GeorgiaTechSystemResearch/GT_MUR_Open_Source_Package/README.md

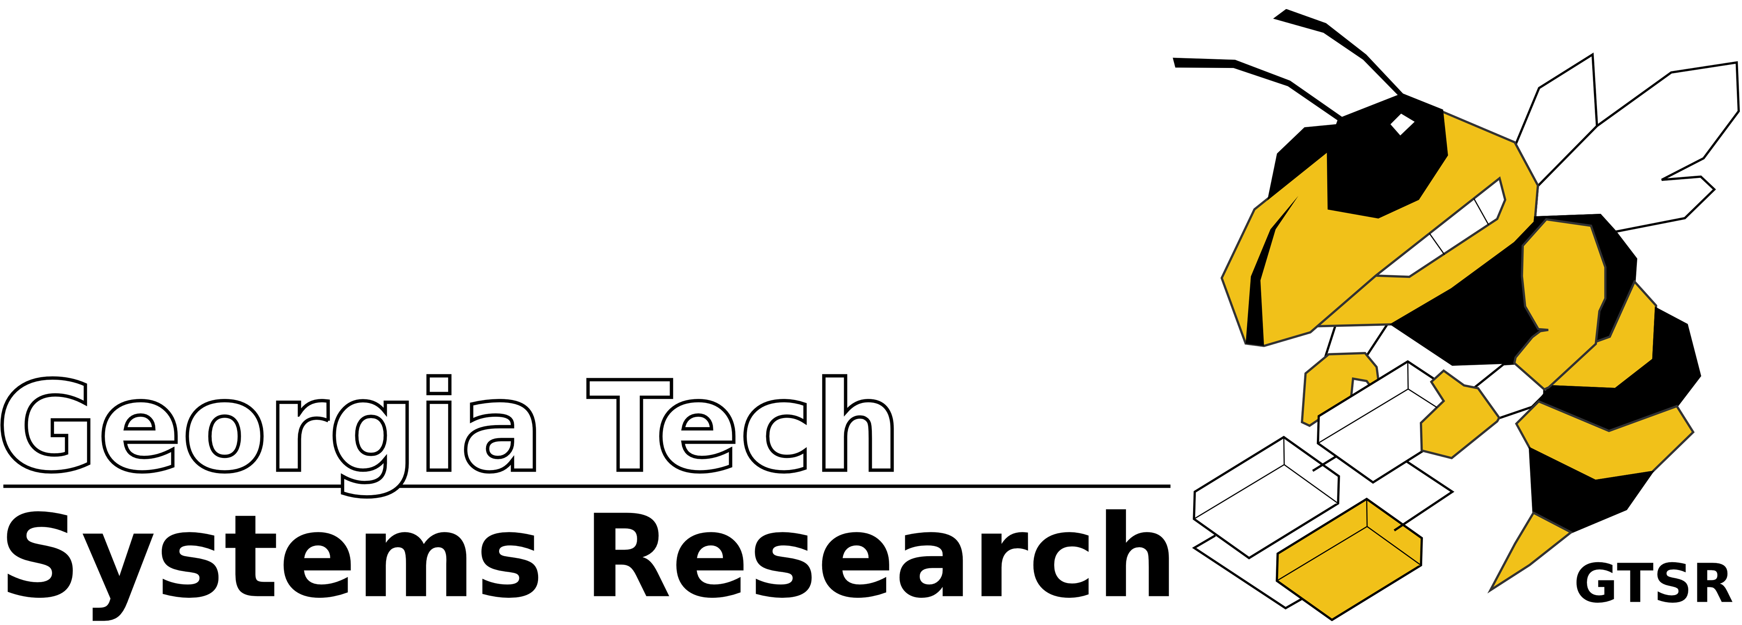
[picture p1: GTSR_logo.png]
