GeorgiaTechSystemResearch/GT_MUR_Open_Source_Package/Mechanical_Design_Files/Dimension_of_Devices/arduino.jpg

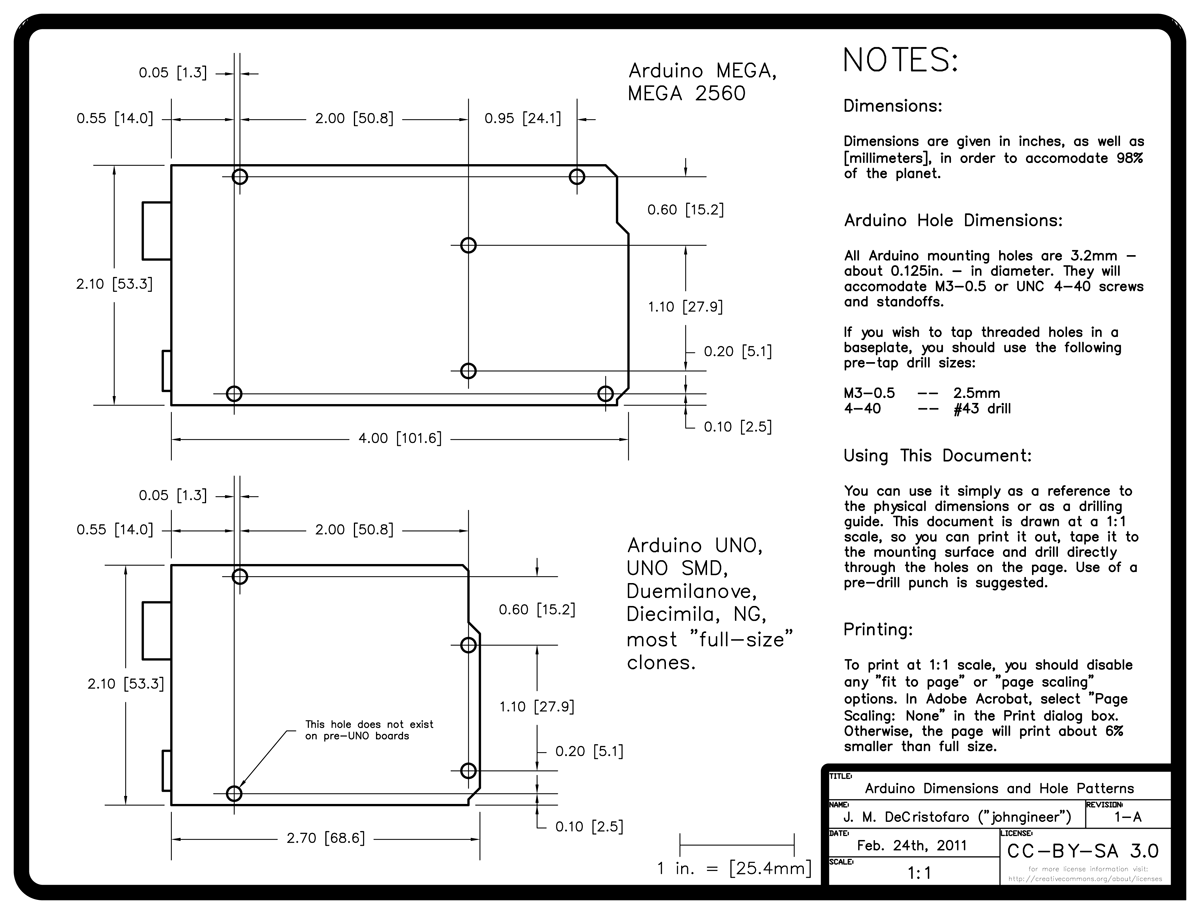
Mechanical_Design_Files/Dimension_of_Devices/arduino.jpg
