GeorgiaTechSystemResearch/GT_MUR_Open_Source_Package/Mechanical_Design_Files/Dimension_of_Devices/ir module V2.png

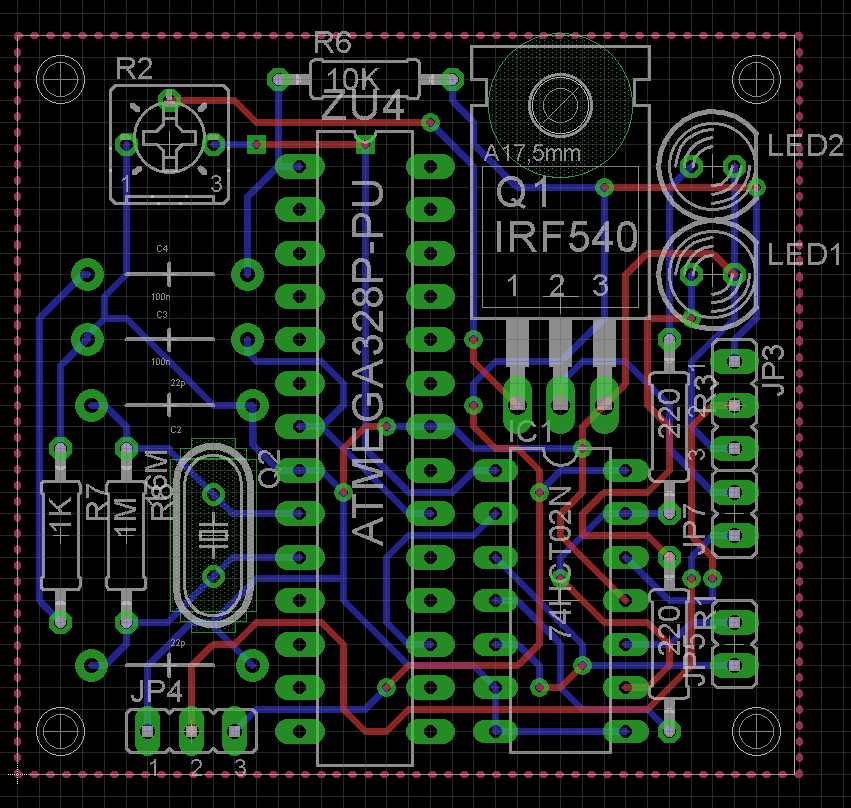
Mechanical_Design_Files/Dimension_of_Devices/ir module V2.png
