GeorgiaTechSystemResearch/GT_MUR_Open_Source_Package/Mechanical_Design_Files/Dimension_of_Devices/LCD_button.JPG

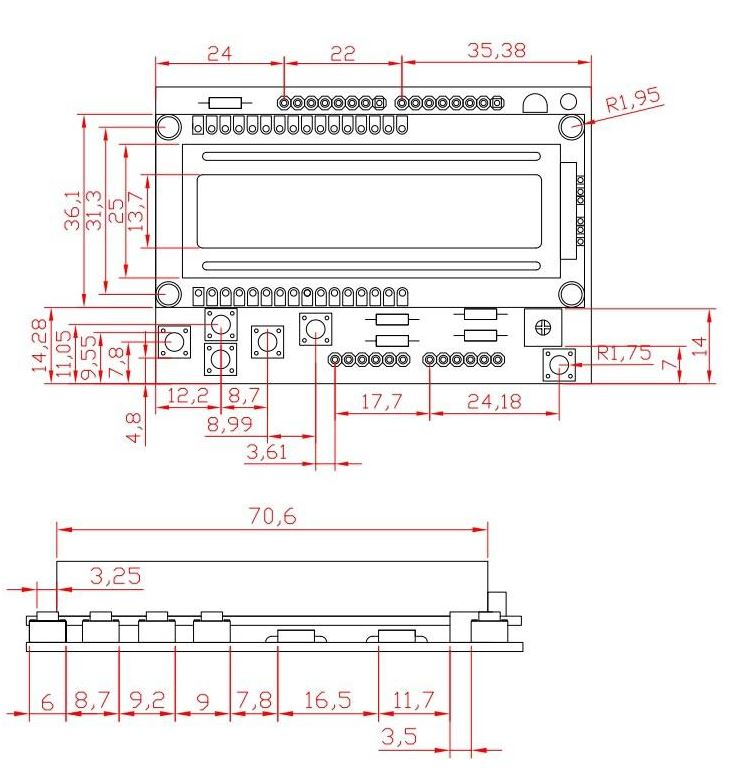
Mechanical_Design_Files/Dimension_of_Devices/LCD_button.JPG
