GeorgiaTechSystemResearch/GT_MUR_Open_Source_Package/Documents/Part_List.xlsx

Mechanical Structure
Part Name | Distributor / Manufacturer | Model / Description / Link
Acrylic Sheet (thin) | Home Depot or Amazon | ~0.125 inch thichness
Acrilic Sheet | Home Depot or Amazon | 0.22/0.25 inch thickness
Acrilic Tube | Amazon | 3 inch OD, 0.22/0.25 inch wall thickness
Rubber Sheet | Amazon or McMaster | 0.125 inch thickness
threaded rod | Home Depot or McMaster | 10-24 thread
wing nuts | Home Depot or McMaster | 10-24 thread
hex nuts | Home Depot or McMaster | 10-24 thread
Nylon screws & nuts | McMaster | M2.5, Nylon
Spacers | McMaster | M2.5 * 5mm and M2.5 * 10mm, Nylon
Electronics - handhold controller
Part Name | Distributor | Model / Description / Link
Arduino Mega 2560 R3 | Amazon / Arduino | Arduino Board with Atmega 2560
Adapter PCB | DFRobot | Design files available in the package
Thumb Joystick | Sparkfun | https://www.sparkfun.com/products/9032
Breakout Board for Thumb Joystick | Sparkfun | https://www.sparkfun.com/products/9110
slide potentiometer | Mouser / Bourns | 10Kohms, 60mm Travel, Center Detent, PTL60-10G1-103B2
Lithium battery | Amazon / Venom | 11.1V, 2200mah, 20C
LCD screen with pushbuttons | Sparkfun | https://www.sparkfun.com/products/11851
DC-DC converter | Amazon / Hobbywing | Hobbywing 5V/6V 3A Switch-mode UBEC
IR transmitter Module | GTSR made | Design files available in the package
Infrered receiver module | Mouser / Vishay | Infrared Receivers 2.5-5.5V 38kHz, TSOP38238
Infrered LED | Mouser / LED Engin | High Power, 940nm Dual Junction, LZ1-10R702
Heatsink | Major Distributors | Altuminum heatsink
Electronics - underwater vehicle
Arduino Mega 2560 R3 | Amazon / Arduino | Arduino Board with Atmega 2560
motors | Turnigy | Aerodrive DST-700 Brushless Outrunner motor 700kv
propeller | Graupner | Graupner 2308.60 and 2308.60L
DC-DC converter | Amazon / Hobbywing | Hobbywing 5V/6V 3A Switch-mode UBEC
motor driver holder PCB | DFRobot | Design files available in the package
10-DOF IMU | Adafruit | Adafruit 10-DOF IMU Breakout
Pressure sensor | Measurement Specialties | MS5803-14BA
IR transmitter Module | GTSR made | Design files available in the package
Infrered LED | Mouser / LED Engin | High Power, 940nm Dual Junction, LZ1-10R702
Infrered receiver module | Mouser / Vishay | Infrared Receivers 2.5-5.5V 38kHz, TSOP38238
Heatsink | Major Distributors | Altuminum heatsink
Electronics - IR Transmitter Module
PCB | DFRobot | Design files available in the package
Potentiometer | Mouser / Bourns | 10KOHMS, Through Hole 1/4"SQ, 3362P-1-103LF
Logic Gate | Mouser / Texas Instruments | NOR gate, SN74HC02N
Atmega328P | Mouser / Atmel | 8-bit Microcontroller, ATMEGA328P-PU
MOSFET | Mouser / Fairchild | 60V N-Channel QFET Logic Level, FQP30N06L
Crystal, 16MHz | Sparkfun | https://www.sparkfun.com/products/536
Capacitor, 22pf | Sparkfun | https://www.sparkfun.com/products/8571
Capacitor, 0.1uf | Mouser / TDK | Multilayer Ceramic Capacitor, 0.1uF, X7R
Led | Major Distributors | 5mm LED, Yellow and Green
Resistor*4 | Major Distributors | General Purpose 1/4W through hole resistors
Pin header | Major Distributors | Pin header, 0.1 inch pitch
