GeorgiaTechSystemResearch/GT_MUR_Open_Source_Package/Mechanical_Design_Files/Hand_hold_Controller/hand_hold_controller.dxf

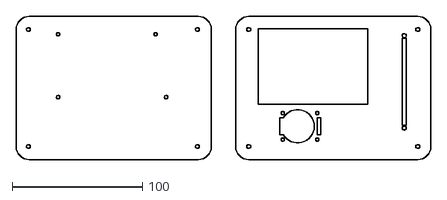
[picture p7: CAD file, 2016-12-27]
Mechanical_Design_Files/Hand_hold_Controller/hand_hold_controller.dxf
318.8 x 110.0
