GeorgiaTechSystemResearch/GT_MUR_Open_Source_Package/Mechanical_Design_Files/Underwater_Vehicle/middle plate.dxf

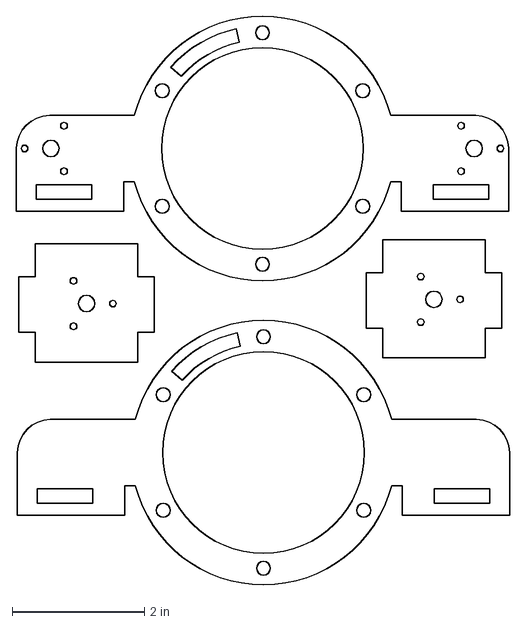
[picture p8: CAD file, 2016-12-27]
Mechanical_Design_Files/Underwater_Vehicle/middle plate.dxf
7.45 x 8.60 in
