GeorgiaTechSystemResearch/GT_MUR_Open_Source_Package/Mechanical_Design_Files/Underwater_Vehicle/middle plate2.dxf

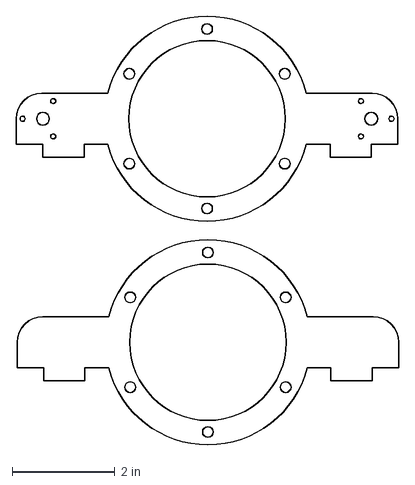
[picture p9: CAD file, 2016-12-27]
Mechanical_Design_Files/Underwater_Vehicle/middle plate2.dxf
7.46 x 8.36 in
