GeorgiaTechSystemResearch/GT_MUR_Open_Source_Package/Mechanical_Design_Files/Underwater_Vehicle/vehicle_stand.dxf

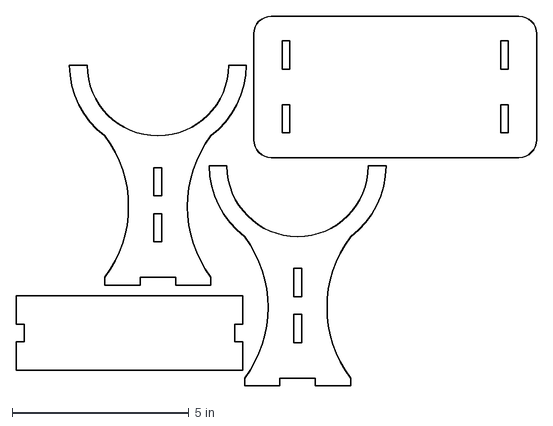
[picture p10: CAD file, 2016-12-27]
Mechanical_Design_Files/Underwater_Vehicle/vehicle_stand.dxf
14.7 x 10.5 in
