GeorgiaTechSystemResearch/GT_MUR_Open_Source_Package/Mechanical_Design_Files/Underwater_Vehicle/electronic_chassis.dxf

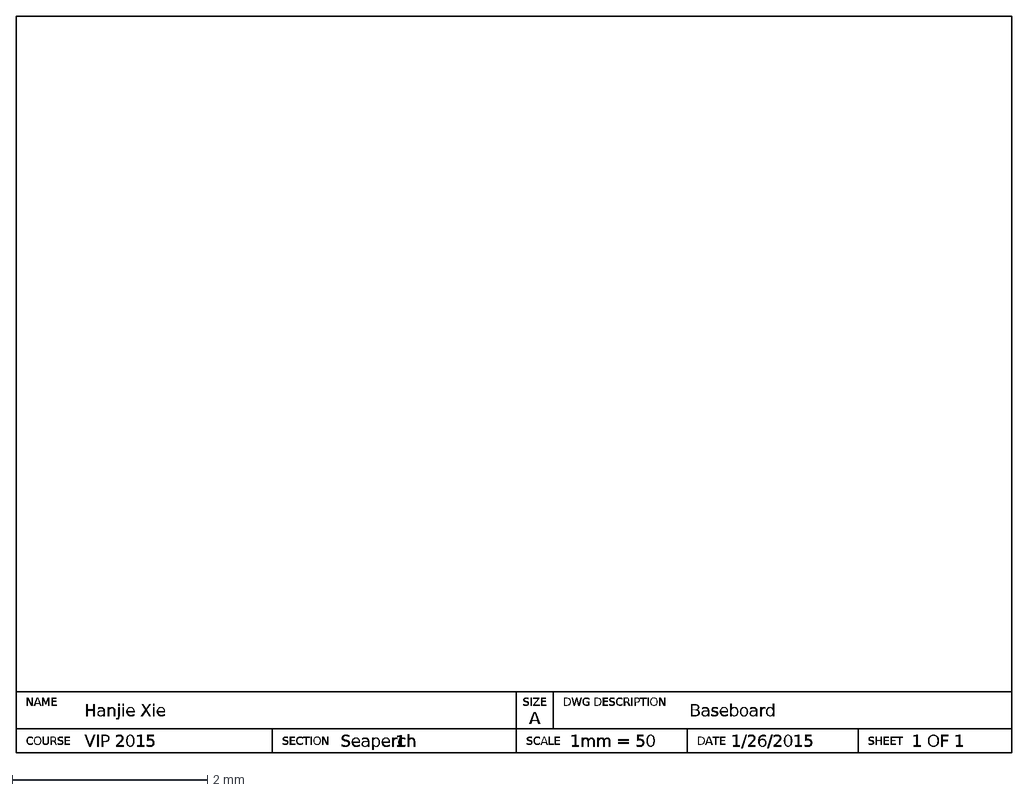
[picture p11: CAD file, 2016-12-27]
Mechanical_Design_Files/Underwater_Vehicle/electronic_chassis.dxf
SIZE
DWG DESCRIPTION
SCALE
NAME
COURSE
SECTION
DATE
SHEET
VIP 2015
A
Hanjie Xie
Seaperch
1mm = 50
1/26/2015
1 OF 1
Baseboard
1
