GeorgiaTechSystemResearch/GT_MUR_Open_Source_Package/(list of files, cad)

Other CAD files:
Mechanical_Design_Files/Underwater_Vehicle/rubber_pad.dwg
Mechanical_Design_Files/Underwater_Vehicle/end_cap with wire cut.dwg
Mechanical_Design_Files/Underwater_Vehicle/end_cap.dwg
