GeorgiaTechSystemResearch/GT_MUR_Open_Source_Package/Electronic_Design_Files/IR Module V3/IR_module_V3.brd

## EAGLE design Electronic_Design_Files/IR Module V3/IR_module_V3.brd (2016-12-27)

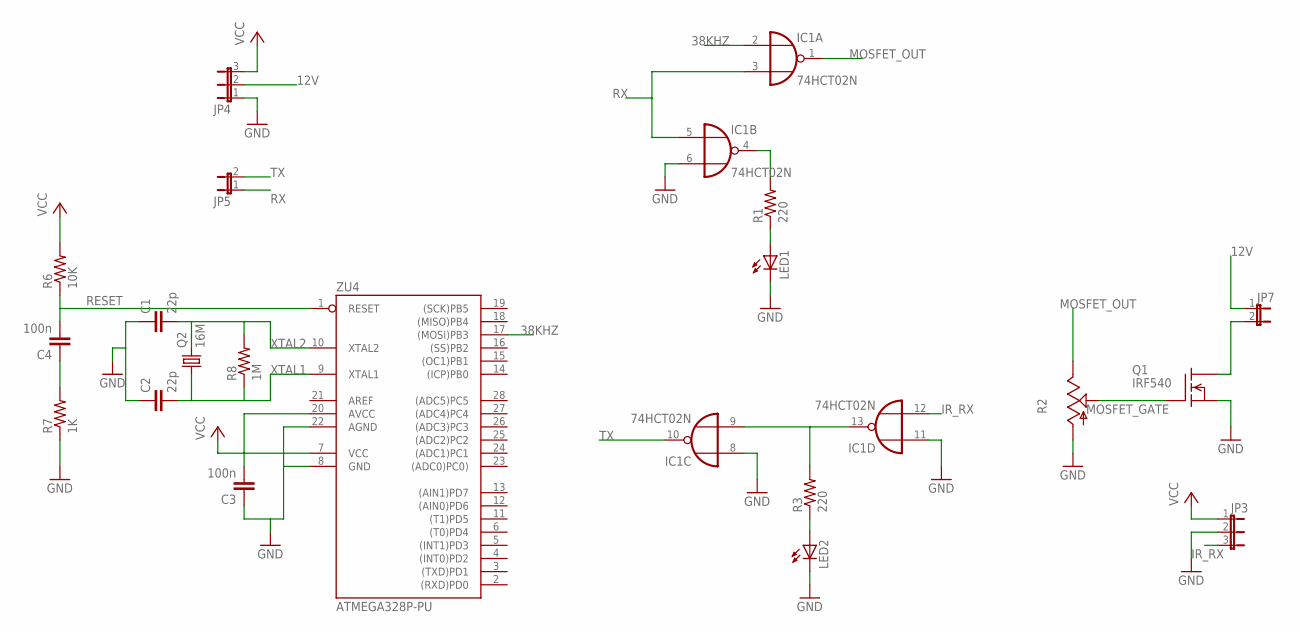
[picture p39: schematic IR_module_V3.sch]

Parts:
C1, C2: 22p; CAP-PTH-SMALLEZ
C3, C4: 100n; CAP-PTH-SMALLEZ
IC1: 74HCT02N; DIL14
JP3, JP4: JP2E; JP2
JP5, JP7: JP1E; JP1
LED1, LED2: LED5MM
Q1: IRF540; TO220
Q2: 16M; HC49/S
R1, R3: 220; 0207/10
R2: TRIM_US-B25P; B25P
R6: 10K; 0207/10
R7: 1K; 0207/10
R8: 1M; 0207/10
ZU4: ATMEGA328P-PU; DIL28-3

Connections:
12V: JP4.2, JP7.1
38KHZ: IC1.2 (I0), ZU4.17 ((MOSI)PB3)
GND: C1.1, C2.1, C3.1, IC1.6 (I1), IC1.7 (GND), IC1.8 (I0), IC1.11 (I0), JP3.2, JP4.1, LED1.K (C), LED2.K (C), Q1.3 (S), R2.A, R7.1, ZU4.8 (GND), ZU4.22 (AGND)
IR_RX: IC1.12 (I1), JP3.3
MOSFET_GATE: Q1.1 (G), R2.S
MOSFET_OUT: IC1.1 (O), R2.E
unnamed: IC1.4 (O), R1.2
unnamed: LED1.A, R1.1
unnamed: IC1.9 (I1), IC1.13 (O), R3.2
unnamed: LED2.A, R3.1
unnamed: JP7.2, Q1.2 (D)
unnamed: C4.1, R7.2
RESET: C4.2, R6.1, ZU4.1 (RESET)
RX: IC1.3 (I1), IC1.5 (I0), JP5.1
TX: IC1.10 (O), JP5.2
VCC: C3.2, IC1.14 (VCC), JP3.1, JP4.3, R6.2, ZU4.7 (VCC), ZU4.20 (AVCC)
XTAL1: C2.2, Q2.1, R8.1, ZU4.9 (XTAL1)
XTAL2: C1.2, Q2.2, R8.2, ZU4.10 (XTAL2)

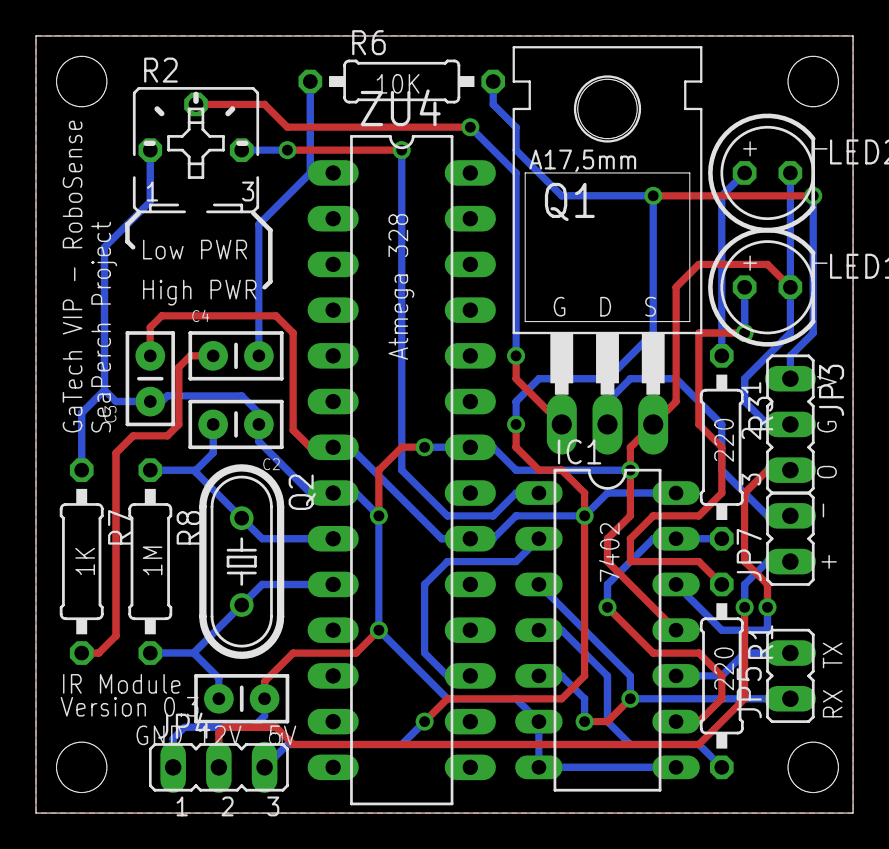
[picture p40: board IR_module_V3.brd from above]

Board: 2 copper layers, 45.4 x 43.2 mm, 20 parts (0 on the bottom side), 18 nets.
