GeorgiaTechSystemResearch/GT_MUR_Open_Source_Package/Electronic_Design_Files/Hand_Hold_Controller/Adapter Board/adapter.brd

## EAGLE design Electronic_Design_Files/Hand_Hold_Controller/Adapter Board/adapter.brd (2016-12-27)

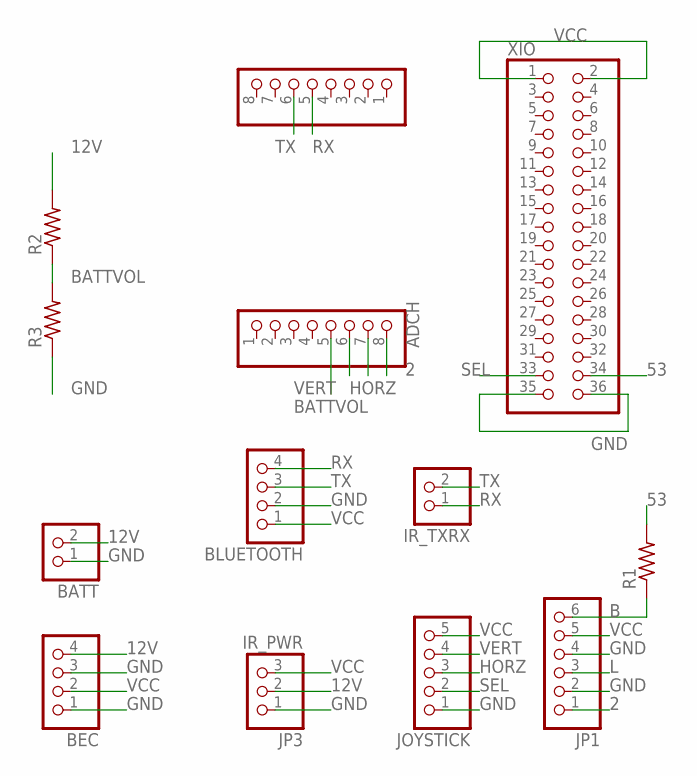
[picture p41: schematic adapter.sch]

Parts:
ADCH: 8x1F-H8.5; 1X08
BATT: PINHD-1X2/90; 1X02/90
BEC: PINHD-1X4/90; 1X04/90
BLUETOOTH: PINHD-1X4/90; 1X04/90
COMMUNICATION: 8x1F-H8.5; 1X08
IR_TXRX: PINHD-1X2/90; 1X02/90
JOYSTICK: PINHD-1X5/90; 1X05/90
JP1: PINHD-1X6/90; 1X06/90
JP3: IR_PWR; 1X03/90
R1, R2, R3: R-US_0207/10; 0207/10
XIO: PINHD-2X18; 2X18

Connections:
2: ADCH.8, JP1.1
12V: BATT.2, BEC.4, JP3.2, R2.2
53: R1.2, XIO.34
B: JP1.6, R1.1
BATTVOL: ADCH.5, R2.1, R3.2
GND: BATT.1, BEC.1, BEC.3, BLUETOOTH.2, JOYSTICK.1, JP1.2, JP1.4, JP3.1, R3.1, XIO.35, XIO.36
HORZ: ADCH.7, JOYSTICK.3
L: JP1.3
RX: BLUETOOTH.4, COMMUNICATION.5, IR_TXRX.1
SEL: JOYSTICK.2, XIO.33
TX: BLUETOOTH.3, COMMUNICATION.6, IR_TXRX.2
VCC: BEC.2, BLUETOOTH.1, JOYSTICK.5, JP1.5, JP3.3, XIO.1, XIO.2
VERT: ADCH.6, JOYSTICK.4

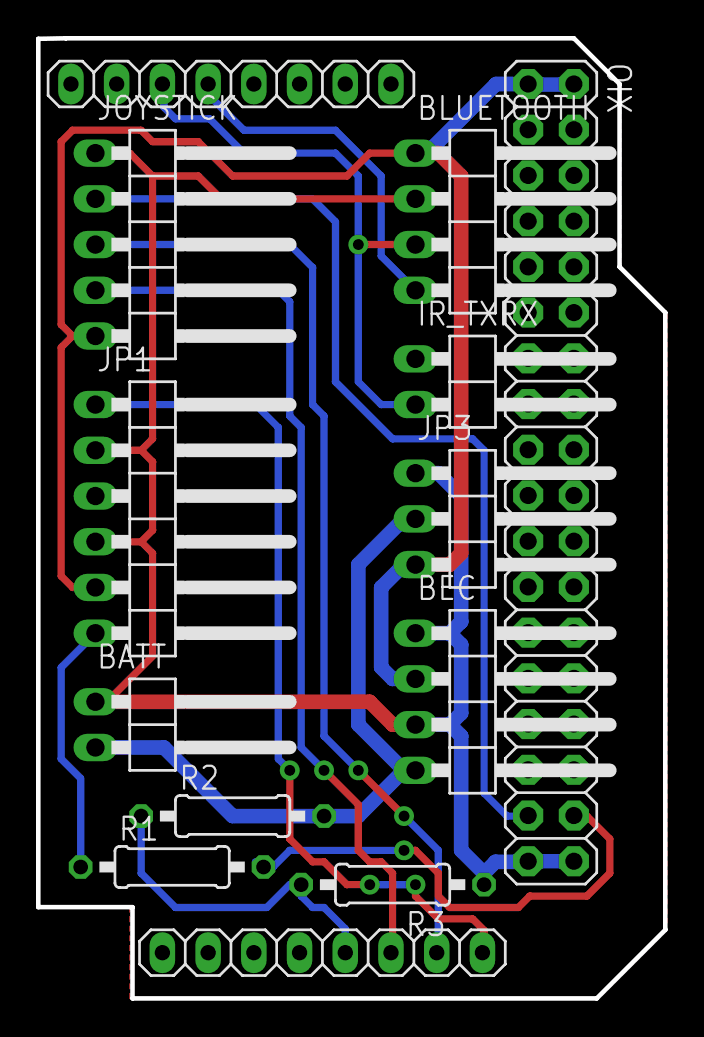
[picture p42: board adapter.brd from above]

Board: 2 copper layers, 34.8 x 53.3 mm, 13 parts (0 on the bottom side), 12 nets.
