GeorgiaTechSystemResearch/GT_MUR_Open_Source_Package/Electronic_Design_Files/Underwater_Vehicle/ESC holder/ESC_holder.brd

## EAGLE design Electronic_Design_Files/Underwater_Vehicle/ESC holder/ESC_holder.brd (2016-12-27)

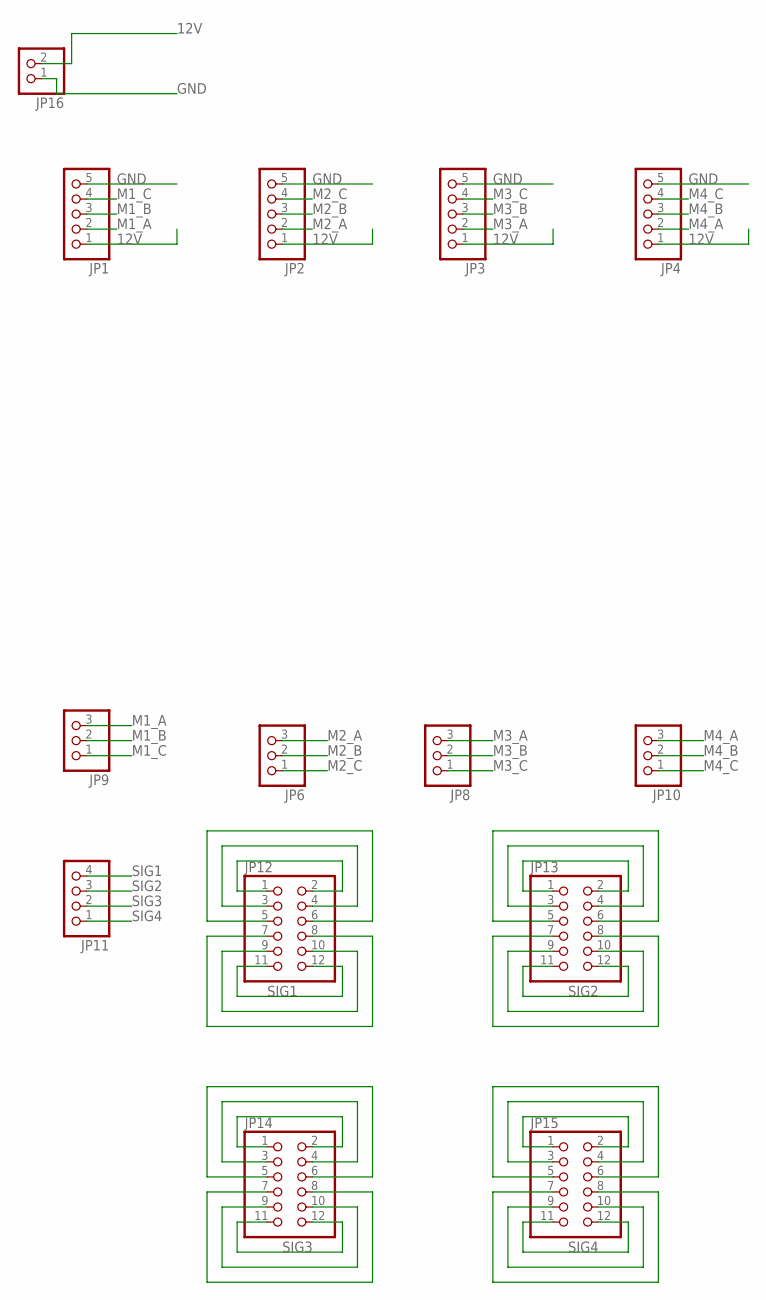
[picture p43: schematic ESC_holder.sch]

Parts:
JP1, JP2, JP3, JP4: PINHD-1X5; 1X05
JP6, JP8, JP9, JP10: PINHD-1X3; 1X03
JP11: PINHD-1X4; 1X04
JP12, JP13, JP14, JP15: PINHD-2X6; 2X06
JP16: PINHD-1X2; 1X02

Connections:
12V: JP1.1, JP2.1, JP3.1, JP4.1, JP16.2
GND: JP1.5, JP2.5, JP3.5, JP4.5, JP16.1
M1_A: JP1.2, JP9.3
M1_B: JP1.3, JP9.2
M1_BLACK: JP12.1, JP12.2
M1_BLACK1: JP13.1, JP13.2
M1_BLACK2: JP14.1, JP14.2
M1_BLACK3: JP15.1, JP15.2
M1_C: JP1.4, JP9.1
M2_A: JP2.2, JP6.3
M2_B: JP2.3, JP6.2
M2_C: JP2.4, JP6.1
M3_A: JP3.2, JP8.3
M3_B: JP3.3, JP8.2
M3_C: JP3.4, JP8.1
M4_A: JP4.2, JP10.3
M4_B: JP4.3, JP10.2
M4_C: JP4.4, JP10.1
unnamed: JP13.3, JP13.4
unnamed: JP12.3, JP12.4
unnamed: JP12.5, JP12.6
unnamed: JP12.7, JP12.8
unnamed: JP12.9, JP12.10
unnamed: JP13.5, JP13.6
unnamed: JP13.7, JP13.8
unnamed: JP13.9, JP13.10
unnamed: JP14.3, JP14.4
unnamed: JP14.5, JP14.6
unnamed: JP14.7, JP14.8
unnamed: JP14.9, JP14.10
unnamed: JP15.3, JP15.4
unnamed: JP15.5, JP15.6
unnamed: JP15.7, JP15.8
unnamed: JP15.9, JP15.10
SIG1: JP11.4, JP12.11, JP12.12
SIG2: JP11.3, JP13.11, JP13.12
SIG3: JP11.2, JP14.11, JP14.12
SIG4: JP11.1, JP15.11, JP15.12

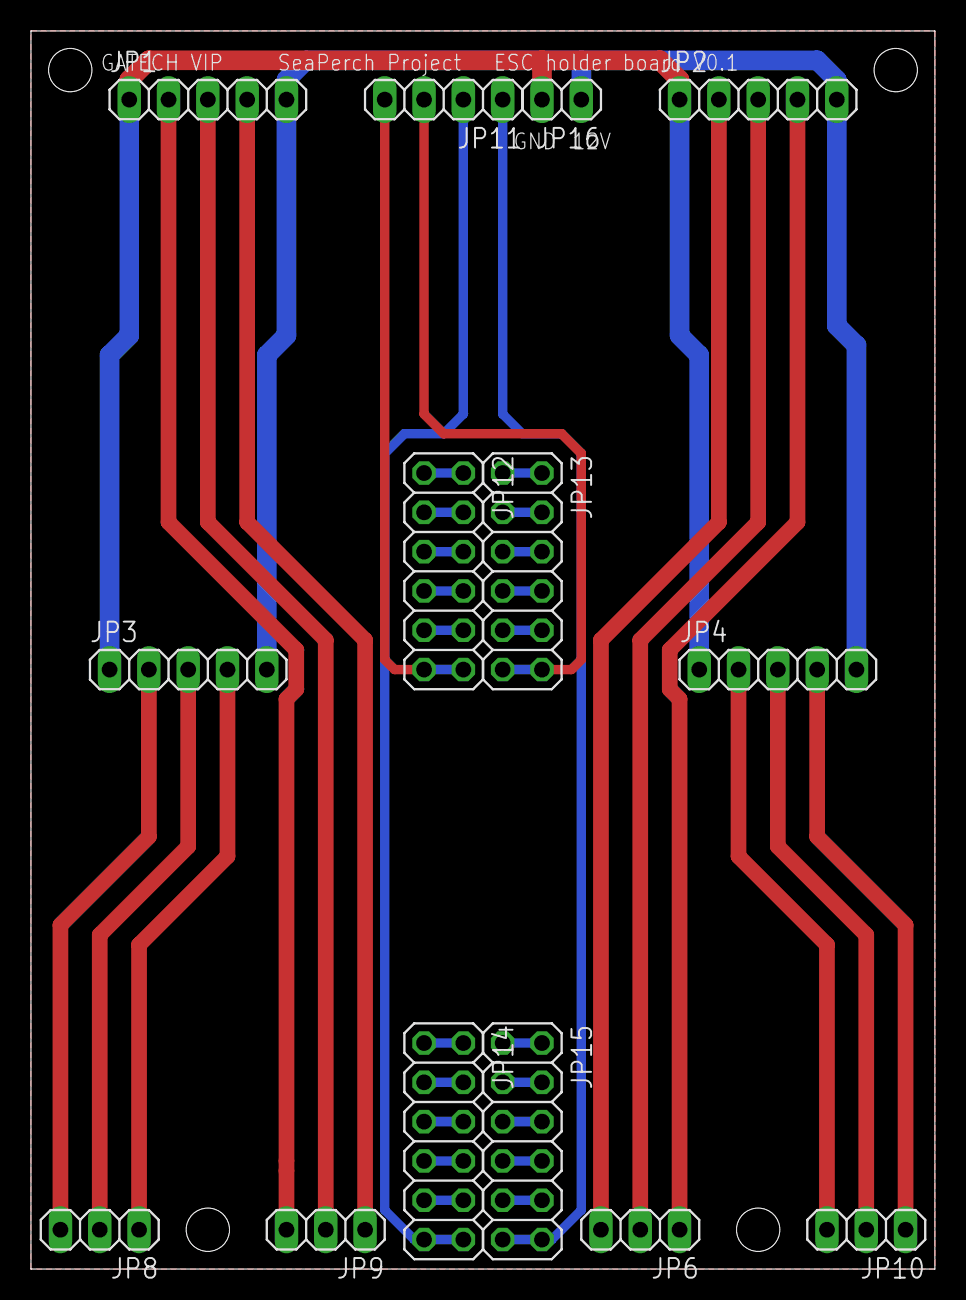
[picture p44: board ESC_holder.brd from above]

Board: 2 copper layers, 58.4 x 80.0 mm, 14 parts (0 on the bottom side), 38 nets.
