GeorgiaTechSystemResearch/GT_MUR_Open_Source_Package/Source_Code/Hand_hold_Controller/RC_Controller/RC_Controller.ino

/*
GT-MUR Remote Control Test

Author: Qiuyang Tao
Electronic Team - Embeded System Group
Virtical Integrated Project - RoboSense
Georgia Institute of Technology

*/
#include <Arduino.h>
#include <LiquidCrystal.h>
#include <SeaPerch_RobotData.h>
#include <SeaPerch_ControlMode.h>
#include <SeaPerch_BinaryUtils.h>
#include <SeaPerch_SerialUtils.h>
#include <SeaPerch_ControlSpecs.h>
#include <SeaPerch_Orientation.h>

#include "Key.h"
#include "ControlPin.h"
#include "KeyDetector.h"
#include "LCDDisplayer.h"
#include "ControlReader.h"
#include "ControlSideByteCoder.h"

RobotData robotData;
ControlSpecs controlSpecs;
LCDDisplayer lcdDisplayer(robotData);
KeyDetector keyDetector;
ControlReader controlReader(lcdDisplayer);
ControlSideByteCoder byteCoder = ControlSideByteCoder(Serial2);
ControlSideCoder &coder = byteCoder;

void setup() {
    lcdDisplayer.initialize();

    Serial.begin(9600);
    Serial1.begin(9600);
    Serial2.begin(2400);
    Serial2.setTimeout(10);

    controlReader.initialize();
}

void loop() {
    controlReader.readControlSpecs(controlSpecs);
    coder.toSerial(controlSpecs);
    delay(500);
    byteCoder.fromSerial(robotData);
    keyDetector.detectKey();
    lcdDisplayer.refresh();
}
